Ruchi12377/RT/docs/img/stop.jpg

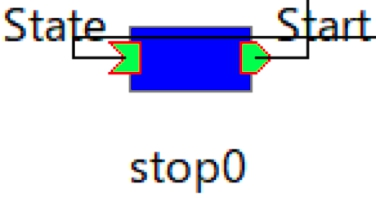
docs/img/stop.jpg
