Ruchi12377/RT/(threads)

Thread 1 (2021-12-06):

README.mdがあるといいです

n-ando, 2021-12-06:
OpenRTMのプロジェクトページの方には説明をすでに書いていただいていますが、Githubに直接来た人のためにREADME.mdがあると良いかと思います。内容としては、プロジェクトページとほぼ同じで良いですが、

- 何のシステムなのか
- 各コンポーネントの役割
- 使用方法、起動方法
- マニュアルへのリンク
- 作成者

程度を簡単に書いておいたほうがよいでしょう。

Ruchi12377, 2021-12-07:
もともとあったマニュアルと内容は同じですがREADMEを追加しました。
「何のシステムなのか」等のことはテスト後に詳しく追記しておきます。

Ruchi12377, 2021-12-07:
>テスト後
12/15以降です。
わかりにくい表現ですみません。

n-ando, 2021-12-08:
READMEが追加確認しました。図も含まれていてわかりやすいです。
テスト中の忙しい時にありがとうございました。
引き続きよろしくお願いします。

Ruchi12377, 2021-12-14:
「何のシステムなのか」についてです。
READMEにシステム概要を追加しました。
使い方、コンポーネントについての説明が書いてあります。

[変更したコミット](https://github.com/Ruchi12377/RT/commit/865aaec10ee5c60dc6bf1f63a22220d3246e7157)

---

[このコメント](https://github.com/Ruchi12377/RT/issues/1#issue-1071648677)の「作成者」について質問なのですが、何についての作成者を書けばよいのでしょうか？
装置を作ったやプログラムを書いた人の名前をという意味でしょうか。

ご確認よろしくおねがいします。

Thread 2 (2021-12-06):

ビデオとマニュアルについて

n-ando, 2021-12-06:
## ビデオ

ビデオはよくできていると思います。
1点だけ 0:40 あたりの
「本体が押し当てることで消すことができます」
の日本語がおかしいです。

本体≠ホワイトボード消しなら
- 「本体がホワイトボード消しを押し当てることで消すことができます」
本体≒ホワイトボード消しなら
- 「本体を押し当てることで消すことができます」
です。

## マニュアル

初めに、このシステムがどのようにホワイトボードの文字を消すのかについての説明が必要。
camera/select (Hanishitei?) コンポーネントの役割のところで、カメラで取得した画像から範囲を指定できそうなことはわかるが、システムが開始から終了までどのように動作するかの説明がないと、何をするシステムなのかマニュアルからはわからない。

サラッと読んで以下の印象を持ちました。

- camera RTCは何に使うの？→ホワイトボードを消す前に写真を撮って保存してくれるのかな？
- システムが動き出すトリガーは誰が与えるのか？書いている人、自動？
- 範囲指定するとその範囲だけを消してくれるみたい。じゃぁ、全体を消すときはどのように指示するの？
- start RTC
  - 「ホワイトボードの位置をドラッグ操作にて取得し、トリミングする機能も持たせた。」→GUIを持つRTCなのかな？
  - （後ろまで読んで）GUIで範囲するのはselectか？ならその範囲の座標情報はstart RTCはどうやって受け取るの？InPort (State, Back)は両方ともBooleanなのに。。。？
 - select RTC
   - 「この画像上をマウスで範囲指定すると、その座標を出力する。」→OutPortはTimedLongなのに座標を出力？ソースを見たらString型でした。。。
   - move RTCのInPort trans も同様 (TimedLongではなくTimedStringを使用)

マニュアルはまだ第1版なのでこれから更新されると思いますが、上記のような点についても考慮ください。

yamas-m, 2021-12-15:
ご指摘ありがとうございます。
ビデオに関して、ご指摘いただいた誤字を修正いたしました。
対応が遅くなり申し訳ございません。
今後、動画の内容やレイアウトも更新していき、より分かりやすいものを作成していきたいと考えています。

https://youtu.be/wjWIsPQAju0

Thread 3 (2021-12-06):

moveコンポーネントのコンフィギュレーションパラメータについて

Nobu19800, 2021-12-06:
moveというRTCのコンフィギュレーションパラメータでWidgetにsliderを指定していますが、これが制約条件を適切に指定していないため、意図通りの動作をしていないのではないかと思います。
意図とあっているかどうかは分かりませんが、各パラメータの制約条件を以下のように修正してはどうでしょうか。

- W_width: 0 < x < 2000
- W_height: 0 < x < 500
- M_power_width: 0 < x < 100
- M_power_height: 0 < x < 100

Thread 4 (2021-12-06):

camera、selectコンポーネントについて

Nobu19800, 2021-12-06:
camera、selectというRTCで、cameraコンポーネントで画像データを一旦保存して、画像ファイルのパスを送信後に、selectコンポーネントでファイルを開くという事をしていますが、データポートで直接画像データをやり取りしたほうが他のRTCとも接続しやすくなると思いました。
PythonでCameraImage型とOpenCVの画像データの変換方法が分からない場合は以下のソースコードを参考にしてください。

 - https://github.com/Nobu19800/testOpenRTM-aist/blob/57c91e260c6376574b5f1cc893aced4cf2d30adf/testOutPortpy/testOutPortpy.py
 - https://github.com/Nobu19800/testOpenRTM-aist/blob/57c91e260c6376574b5f1cc893aced4cf2d30adf/testInPortpy/testInPortpy.py

KasaKasanono, 2021-12-13:
ご指摘ありがとうございます。
直接ポートで画像データをやりとりできるよう改善しました。
[改善したコミット](https://github.com/Ruchi12377/RT/commit/028fac96d1ae6daee9b69cfebc3138495ebea3f5)
ご確認よろしくお願いします。

Nobu19800, 2021-12-14:
確認しました。修正していただいてありがとうございます。

Closed 2021-12-14.

Thread 5 (2021-12-14):

startコンポーネントのTransというOutPortについて

Nobu19800, 2021-12-14:
startコンポーネントにTransというOutPortがありますが、マニュアルではポート名がPathになっています。
また4つの数値を文字列に変換してTimedString型のデータに格納していますが、使い方が分かりづらいと思います。
いくつか方法はあると思いますが、例えばTimedDoubleSeq型の1番目に始点のx座標、2番目にy座標、3番目に終点のx座標、4番目にy座標という事でやるのも直感的ではないため、独自データ型を定義するか、あるいは既存のデータ型でやろうと思うとTimedGeometry2D型でやり取りしたほうがいいと思います。

また別件ですが、#4 でデータ型を変更しましたが、マニュアルに反映されていないように見えます。
