Ruchi12377/RT/(commit log)

2021-11-29 動くように修正
2021-12-07 Readmeの追加
    README.mdの追加
    それに伴う説明画像の追加
    README作成に必要なdocsファイルを共有しないように設定
2021-12-07 誤字脱字の修正
2021-12-12 説明の追加
    2-3 selectと2-5 moveの説明が抜けていた為追加
2021-12-13 Arduino用にプログラムを変更
2021-12-13 画像の入出力をポートのみで行えるように修正
2021-12-13 各関数の実装を追加
2021-12-13 直接ステッピングモーターを移動できる関数を追加
2021-12-13 関数名を変数で定義し置き換え
2021-12-14 共通部分の切り出し、バグ修正、ログを出すように
2021-12-14 メンバー名部分の修正
2021-12-14 移動関数の修正
2021-12-14 テストコードの追加
2021-12-14 ピン変更
2021-12-14 ハード側のバグ修正。薄板を消すための関数を追加
2021-12-14 バグ修正
2021-12-14 変数定義の修正
2021-12-14 コンフィギュレーションの変数名を変更
2021-12-14 システム概要の追加
2021-12-14 コンポーネントをフォルダにまとめた
2021-12-14 readmeがあるので不要なファイルの削除
2021-12-14 表記ゆれの修正
2021-12-14 モジュールを呼び出すように変更
2021-12-14 stopコンポーネントの削除
2021-12-15 stopの残骸を削除
2021-12-15 外部からモジュールとして呼び出せるように変更
2021-12-15 不要箇所の削除
2021-12-15 wasdで制御できる実験用のコードを追加
2021-12-15 バグの修正とテスト用ファイルの削除
